RaulBlancoGonzalez/Bionic-Hand-Mano-Bi-nica---2019/IMG/Robot50%.jpg

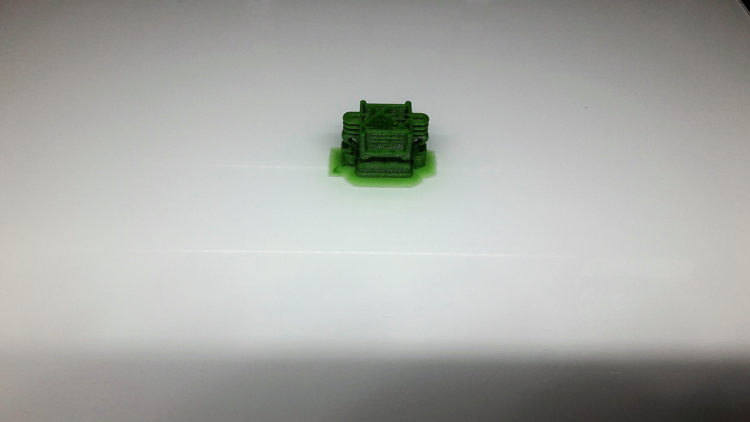
IMG/Robot50%.jpg
