RaulBlancoGonzalez/Bionic-Hand-Mano-Bi-nica---2019/IMG/Robot1%.jpg

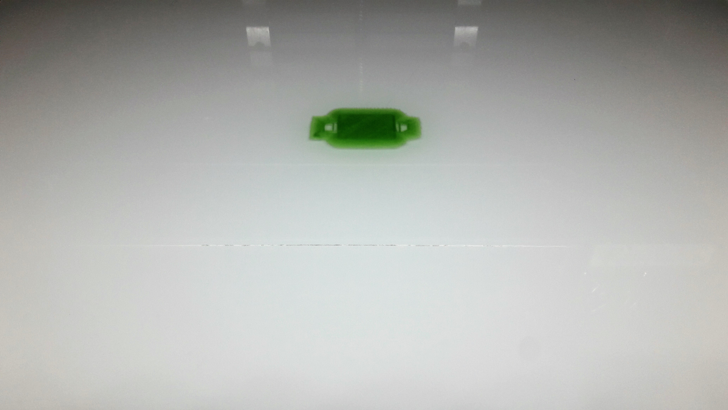
IMG/Robot1%.jpg
