RaulBlancoGonzalez/Bionic-Hand-Mano-Bi-nica---2019/IMG/Arduino_Proto_Shield.jpg

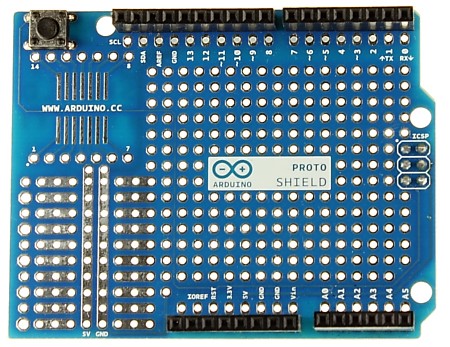
IMG/Arduino_Proto_Shield.jpg
