RaulBlancoGonzalez/Bionic-Hand-Mano-Bi-nica---2019/IMG/Connection.jpg

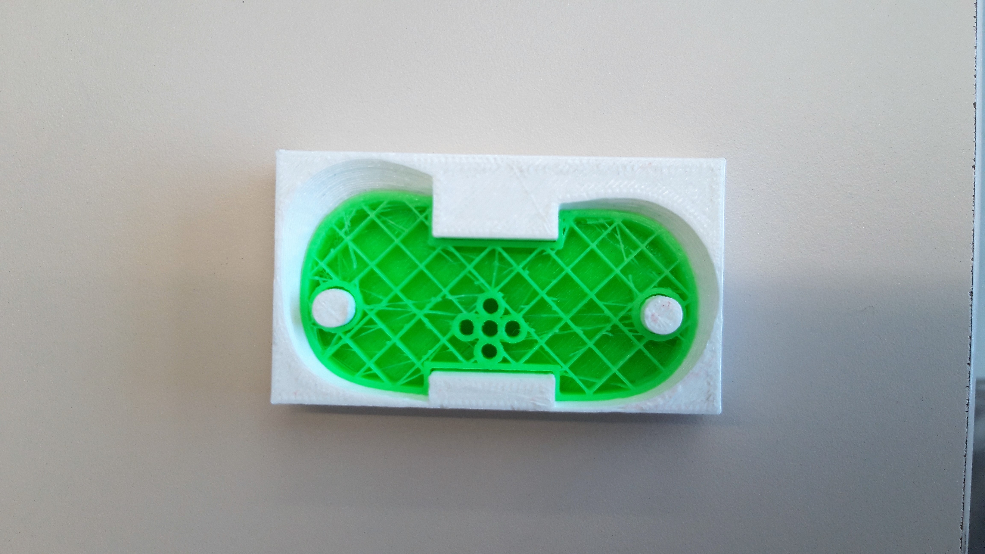
IMG/Connection.jpg
