RaulBlancoGonzalez/Bionic-Hand-Mano-Bi-nica---2019/IMG/Cross_Servo.jpg

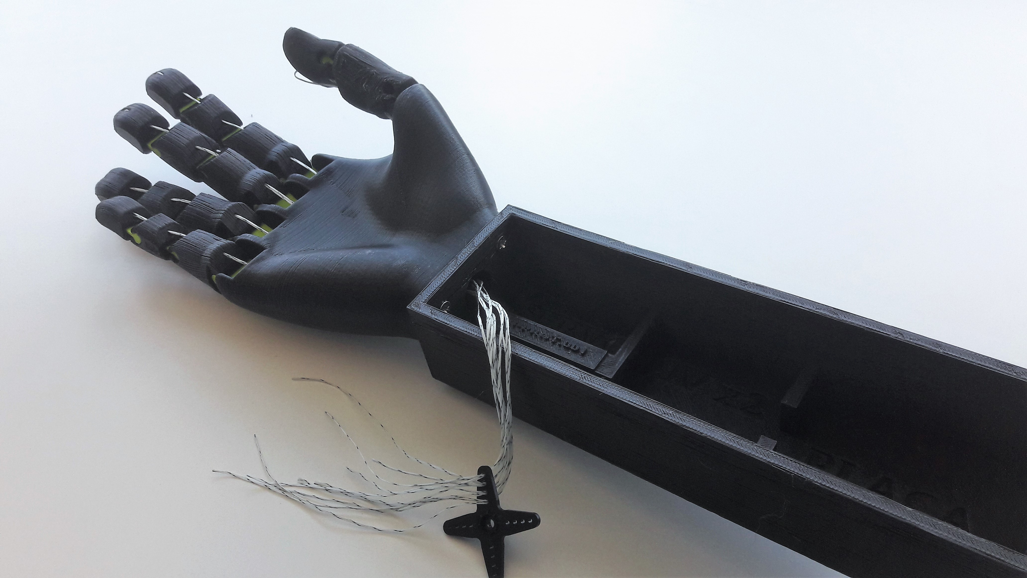
IMG/Cross_Servo.jpg
