RaulBlancoGonzalez/Bionic-Hand-Mano-Bi-nica---2019/IMG/Hand_Close.jpg

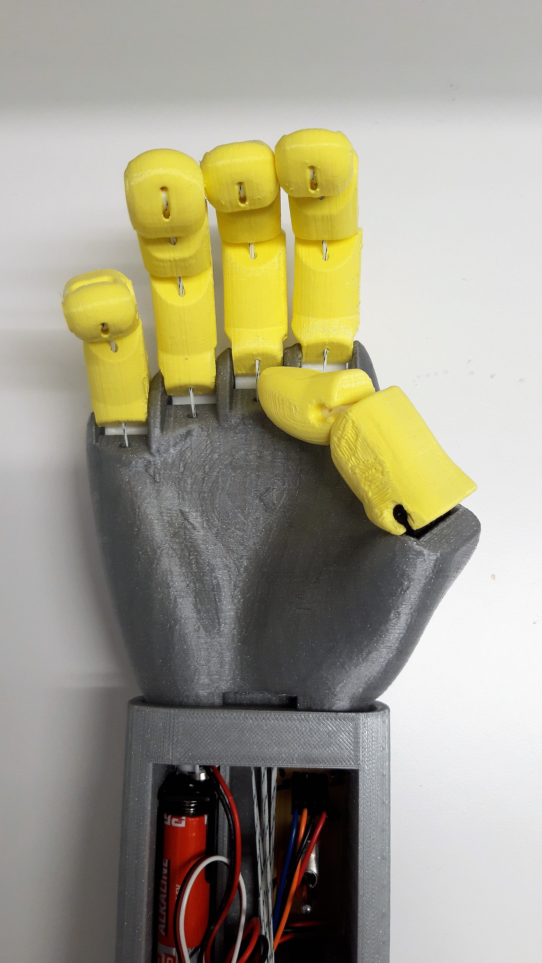
IMG/Hand_Close.jpg
