RaulBlancoGonzalez/Bionic-Hand-Mano-Bi-nica---2019/IMG/Hand_Open.jpg

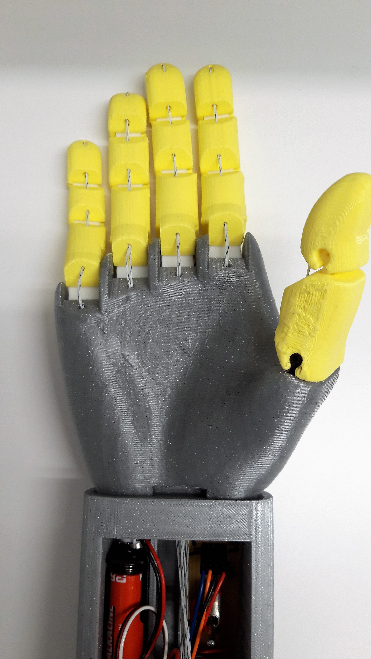
IMG/Hand_Open.jpg
