RaulBlancoGonzalez/Bionic-Hand-Mano-Bi-nica---2019/IMG/PCB.jpg

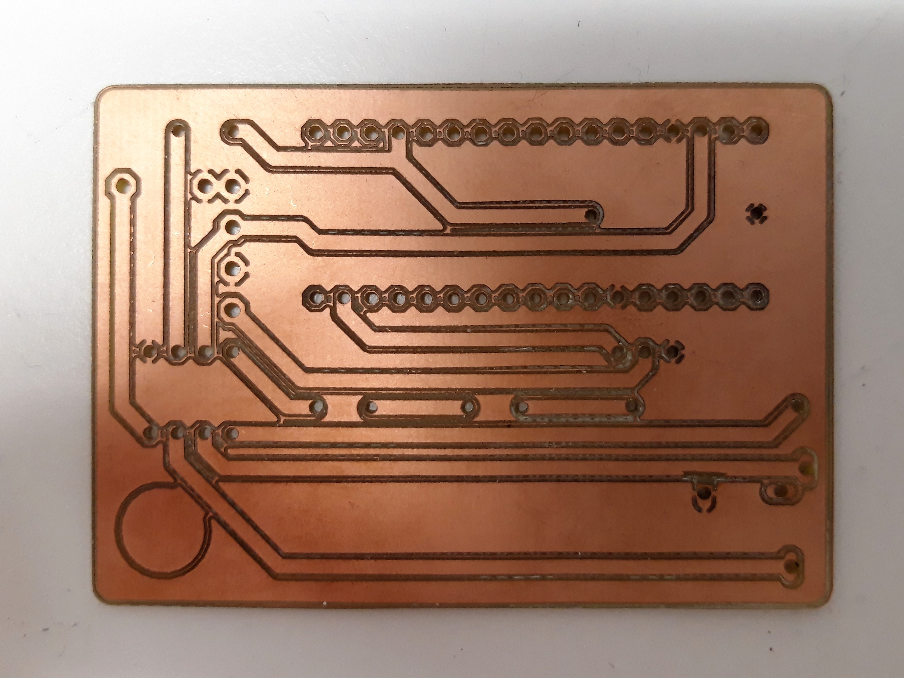
IMG/PCB.jpg
