RaulBlancoGonzalez/Bionic-Hand-Mano-Bi-nica---2019/IMG/PCB_Eagle.jpg

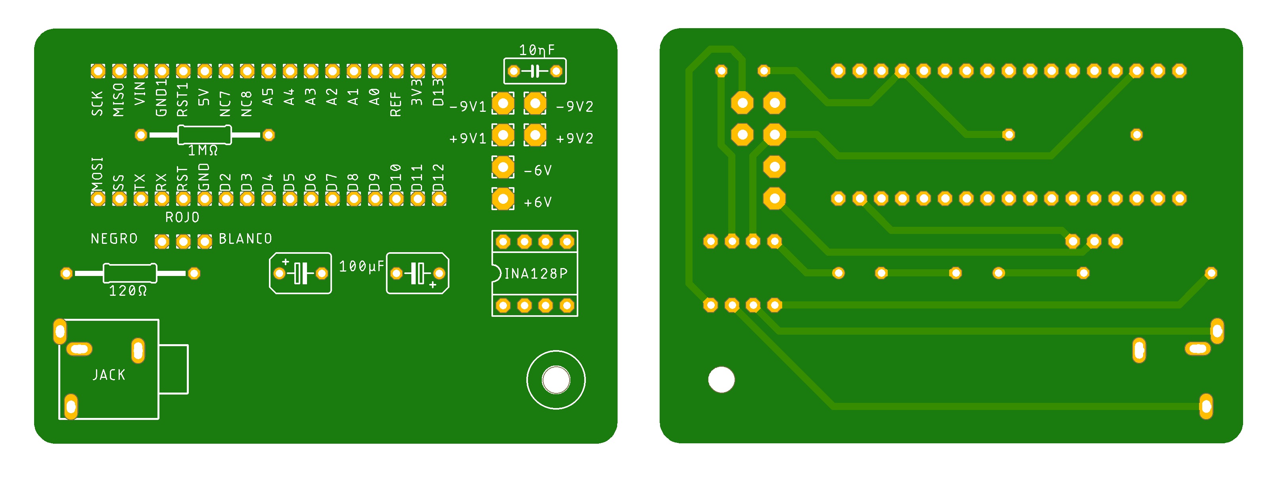
IMG/PCB_Eagle.jpg
