RaulBlancoGonzalez/Bionic-Hand-Mano-Bi-nica---2019/IMG/Robot.jpg

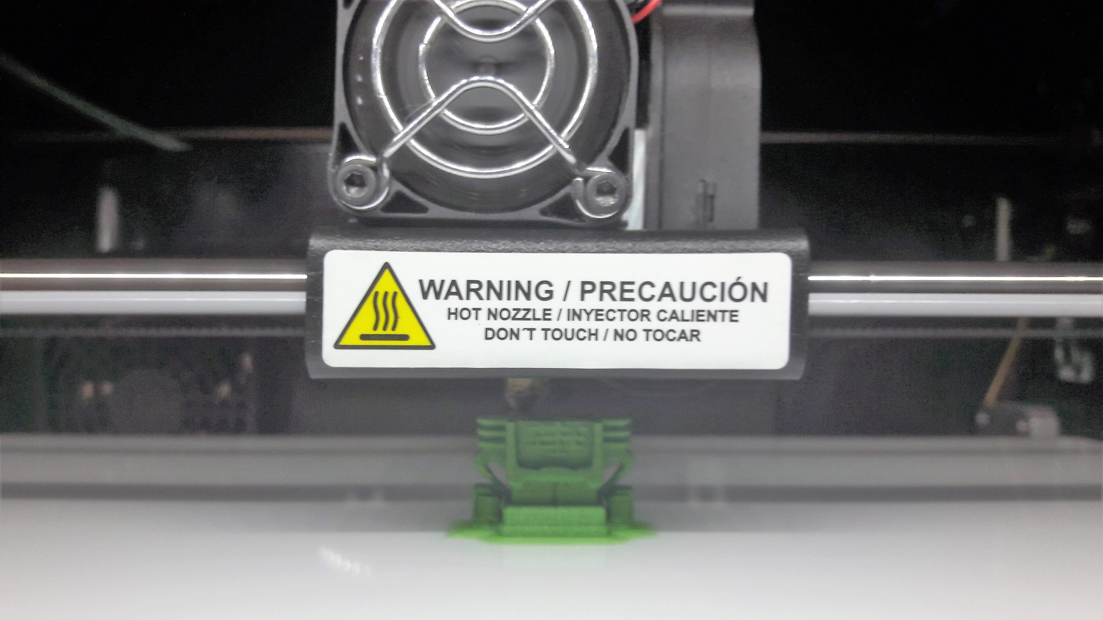
IMG/Robot.jpg
