RaulBlancoGonzalez/Bionic-Hand-Mano-Bi-nica---2019/IMG/Servo_Forearm.jpg

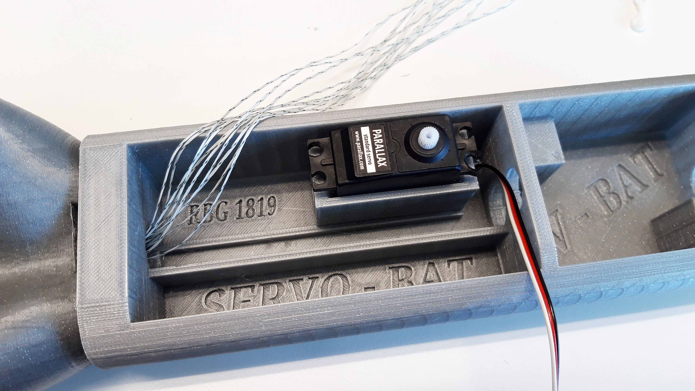
IMG/Servo_Forearm.jpg
