RaulBlancoGonzalez/Bionic-Hand-Mano-Bi-nica---2019/IMG/Stripboard.jpg

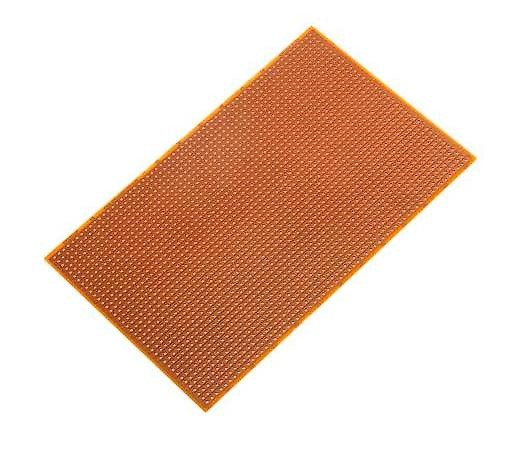
IMG/Stripboard.jpg
