RaulBlancoGonzalez/Bionic-Hand-Mano-Bi-nica---2019/PCB/FINAL/Main_Board/Final_Bottom.png

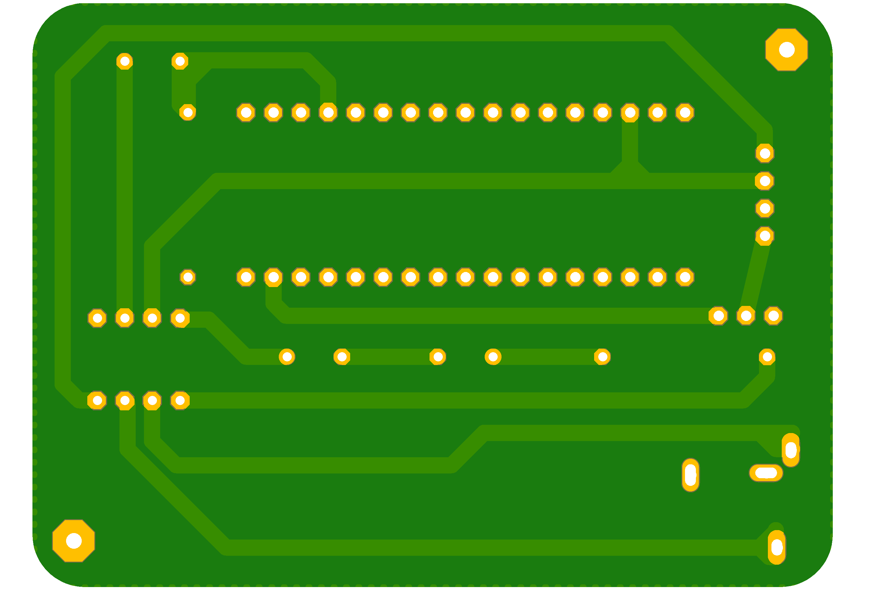
PCB/FINAL/Main_Board/Final_Bottom.png
