RaulBlancoGonzalez/Bionic-Hand-Mano-Bi-nica---2019/PCB/FINAL/Main_Board/Final_Top.png

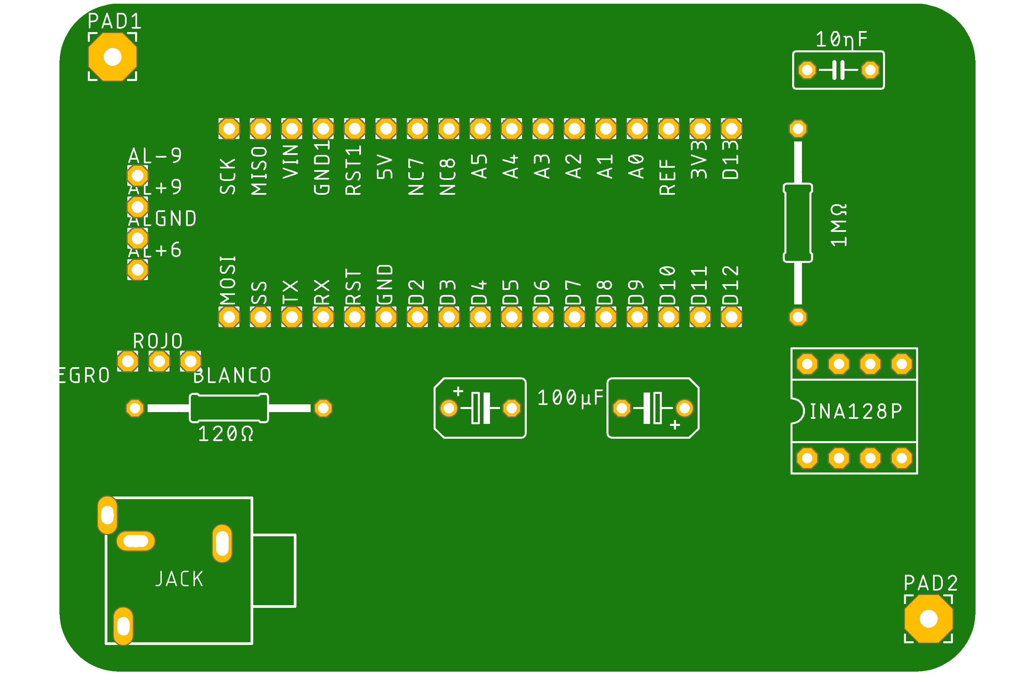
PCB/FINAL/Main_Board/Final_Top.png
