RaulBlancoGonzalez/Bionic-Hand-Mano-Bi-nica---2019/PCB/FINAL/Power_Board/Power_Bottom.png

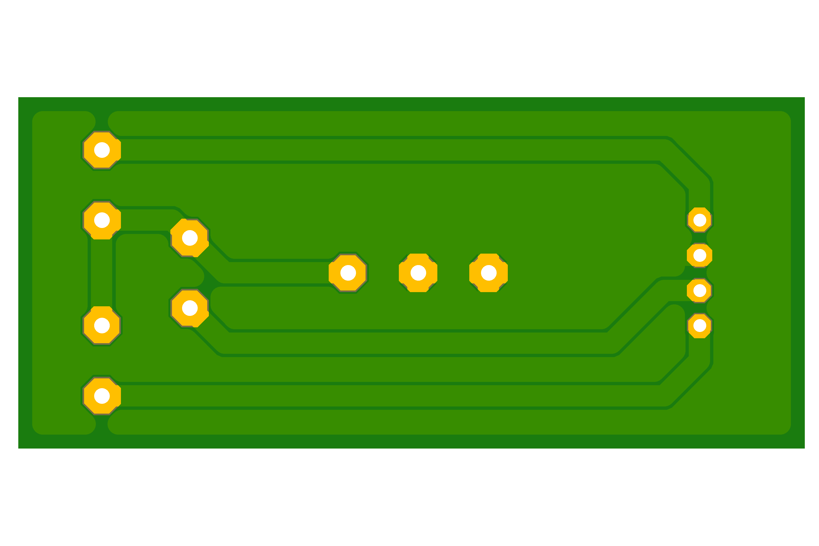
PCB/FINAL/Power_Board/Power_Bottom.png
