RaulBlancoGonzalez/Bionic-Hand-Mano-Bi-nica---2019/PCB/MOD/MOD_Bottom.png

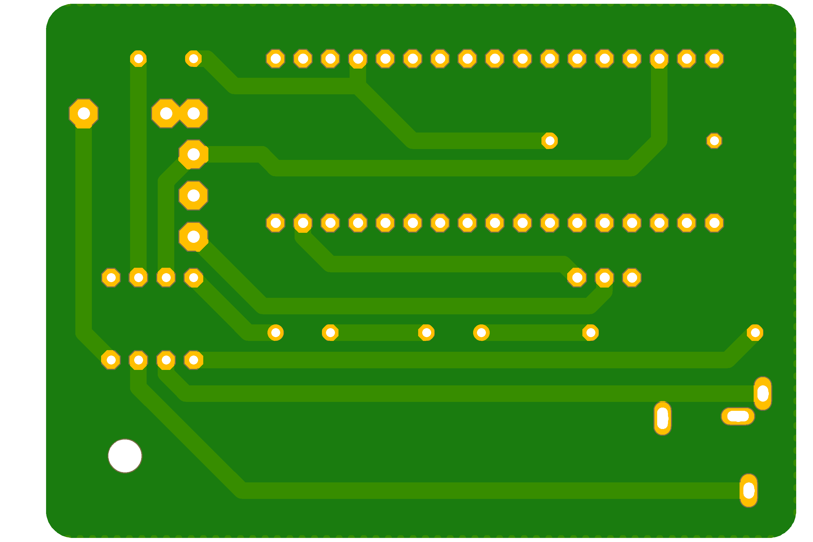
PCB/MOD/MOD_Bottom.png
