RaulBlancoGonzalez/Bionic-Hand-Mano-Bi-nica---2019/PCB/MOD/MOD_Top.png

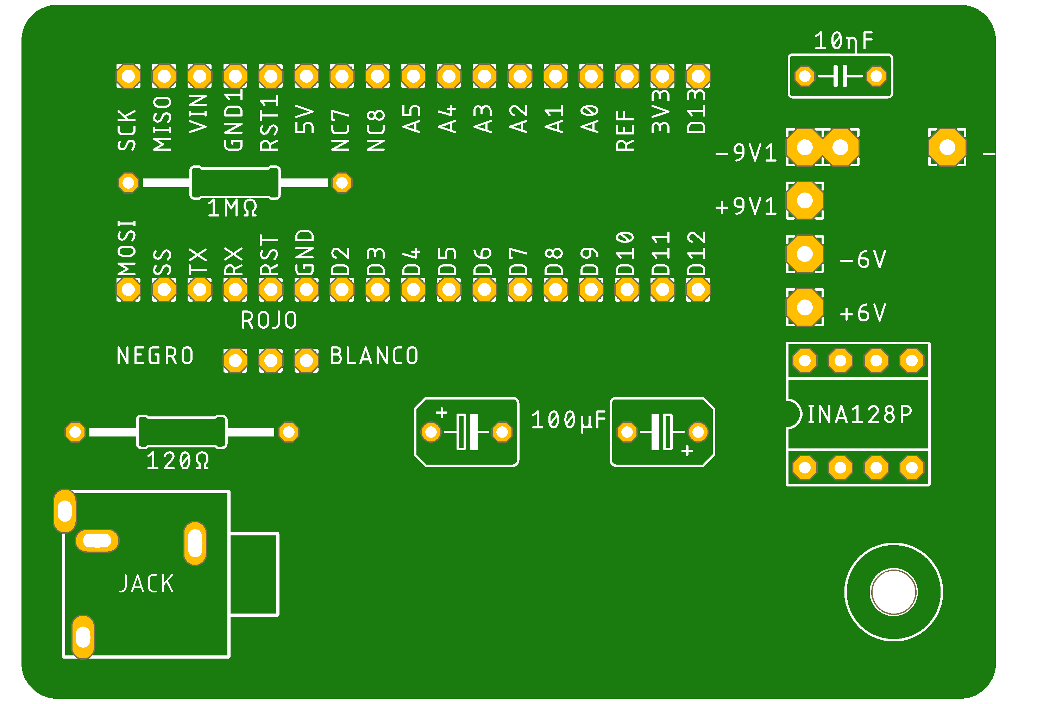
PCB/MOD/MOD_Top.png
