RaulBlancoGonzalez/Bionic-Hand-Mano-Bi-nica---2019/PCB/ORIGINAL/Original_Bottom.png

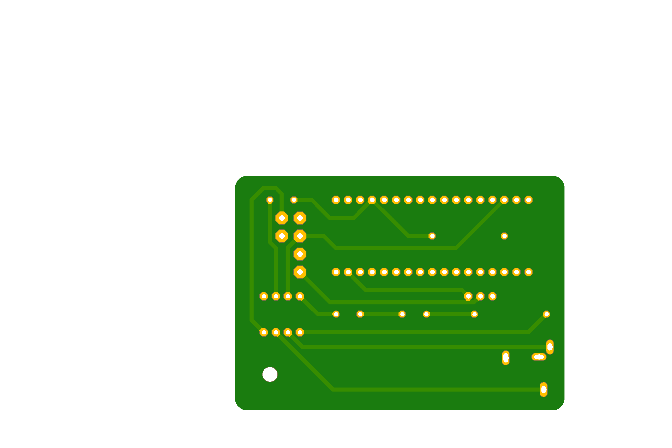
PCB/ORIGINAL/Original_Bottom.png
