RaulBlancoGonzalez/Bionic-Hand-Mano-Bi-nica---2019/PCB/ORIGINAL/Original_Top.png

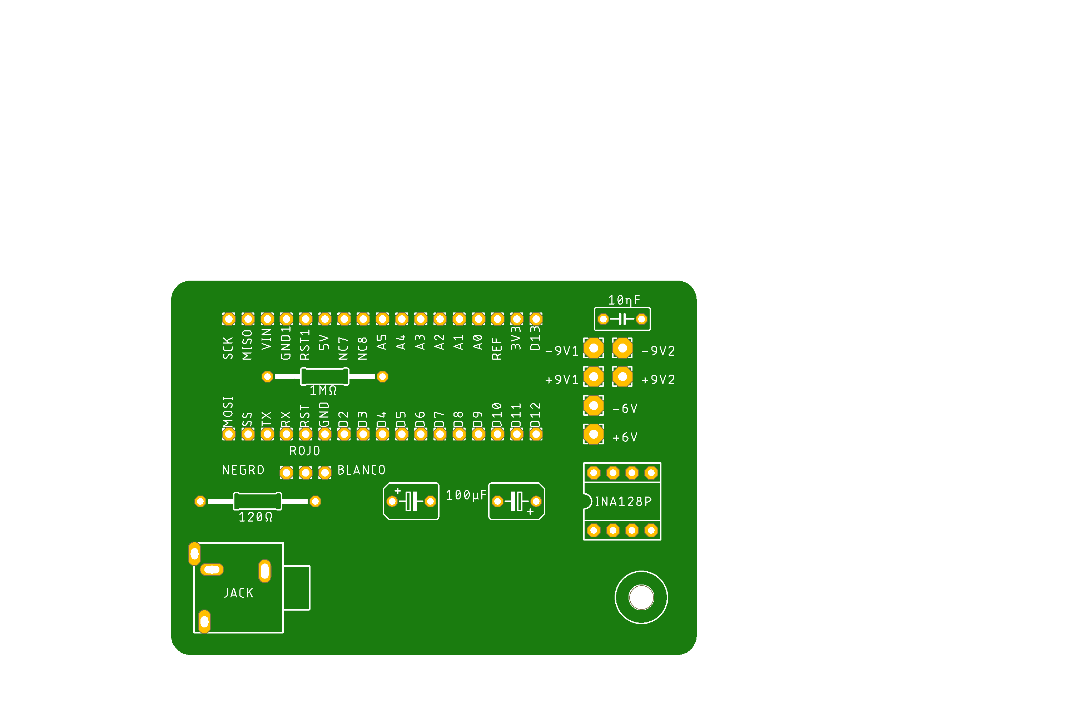
PCB/ORIGINAL/Original_Top.png
