RaulBlancoGonzalez/Bionic-Hand-Mano-Bi-nica---2019/SCH/Arduino_Proto_Shield_Back.jpg

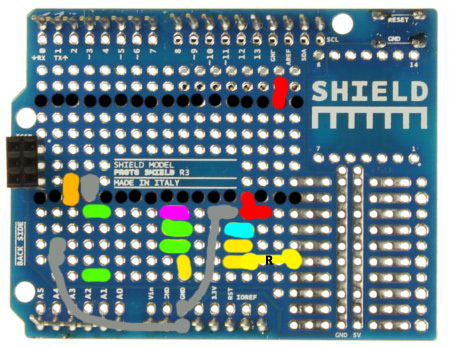
SCH/Arduino_Proto_Shield_Back.jpg
