RaulBlancoGonzalez/Bionic-Hand-Mano-Bi-nica---2019/SCH/EMG.jpg

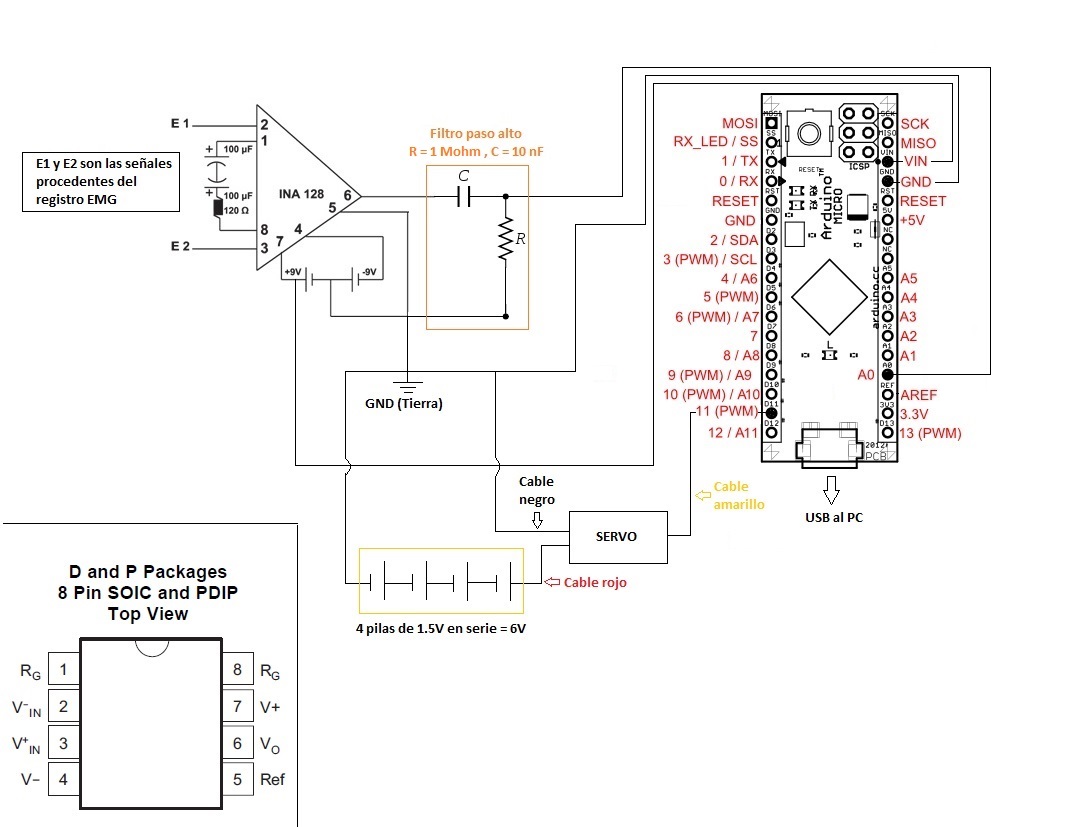
SCH/EMG.jpg
