RaulBlancoGonzalez/Bionic-Hand-Mano-Bi-nica---2019/SCH/Homemade_Scheme_Switch.png

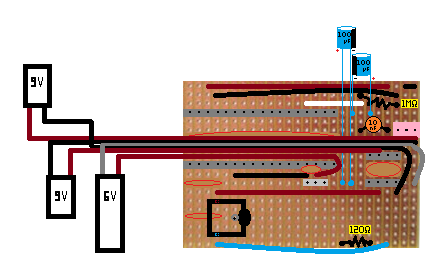
SCH/Homemade_Scheme_Switch.png
