RaulBlancoGonzalez/Bionic-Hand-Mano-Bi-nica---2019/3D/STL/Right_Hand/PLA/Right_Hand_Complete_Set_No_Joints.stl

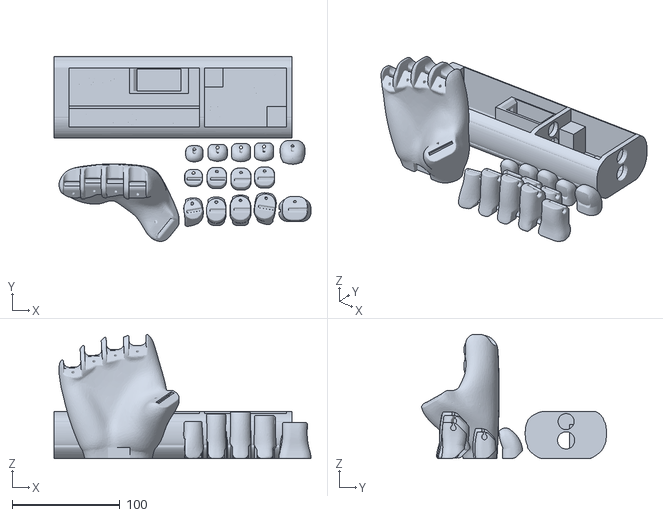
[picture p44: CAD file, 2019-06-21]
3D/STL/Right_Hand/PLA/Right_Hand_Complete_Set_No_Joints.stl
238.8 x 171.8 x 115.6
