RaulBlancoGonzalez/Bionic-Hand-Mano-Bi-nica---2019/3D/STL/Left_Hand/FLEX/Small_Joint.stl

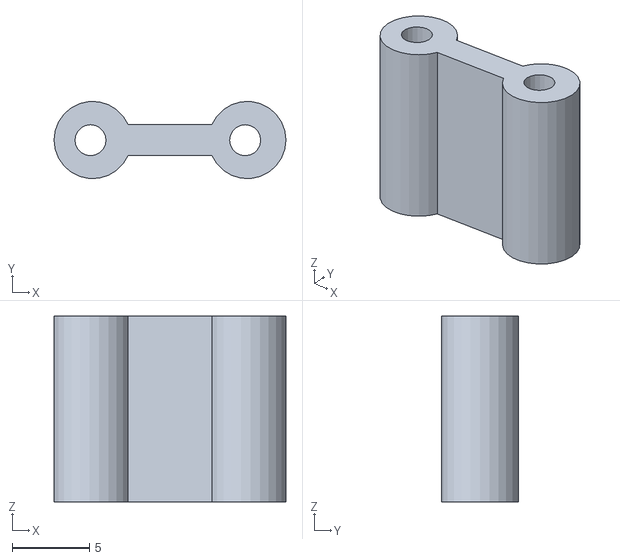
[picture p45: CAD file, 2019-06-21]
3D/STL/Left_Hand/FLEX/Small_Joint.stl
15.0 x 4.98 x 12.0
