RaulBlancoGonzalez/Bionic-Hand-Mano-Bi-nica---2019/3D/STL/Left_Hand/PLA/Left_Fingers.stl

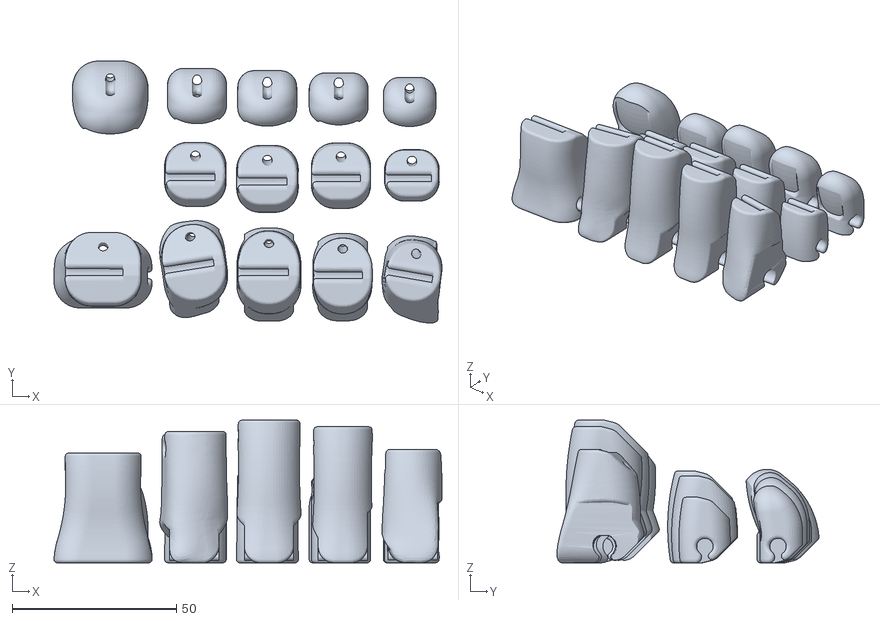
[picture p46: CAD file, 2019-06-21]
3D/STL/Left_Hand/PLA/Left_Fingers.stl
118.3 x 79.9 x 43.5
