RaulBlancoGonzalez/Bionic-Hand-Mano-Bi-nica---2019/3D/STL/Right_Hand/FLEX/Joint_Set.stl

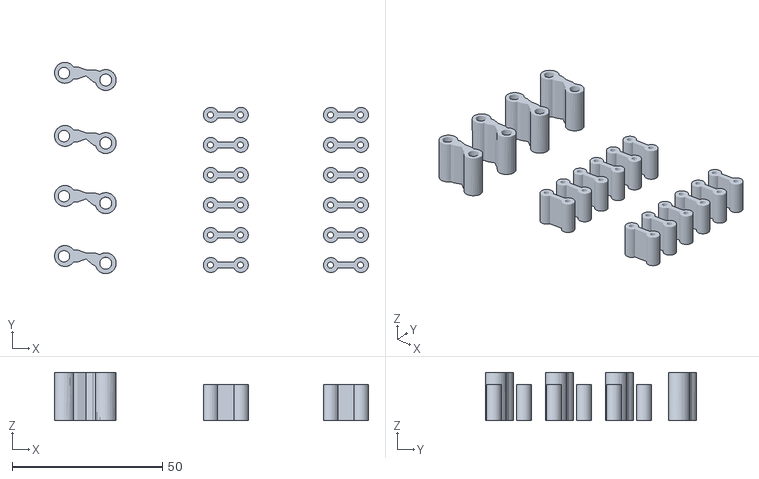
[picture p47: CAD file, 2019-06-21]
3D/STL/Right_Hand/FLEX/Joint_Set.stl
104.5 x 70.4 x 16.0
