RaulBlancoGonzalez/Bionic-Hand-Mano-Bi-nica---2019/3D/STL/Right_Hand/PLA/Right_Hand.stl

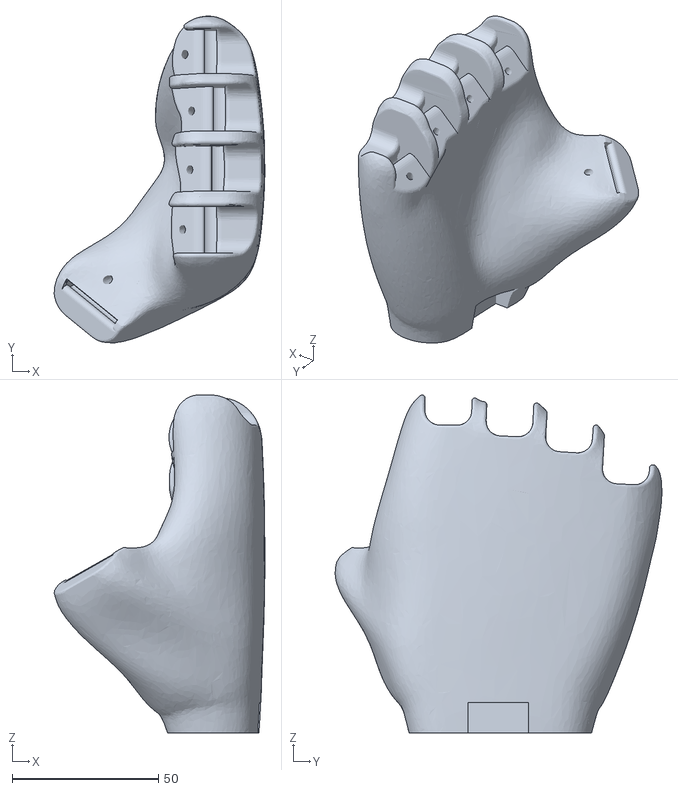
[picture p48: CAD file, 2019-06-21]
3D/STL/Right_Hand/PLA/Right_Hand.stl
72.0 x 111.7 x 115.6
