RaulBlancoGonzalez/Bionic-Hand-Mano-Bi-nica---2019/3D/STL/Left_Hand/PLA/Left_Forearm.stl

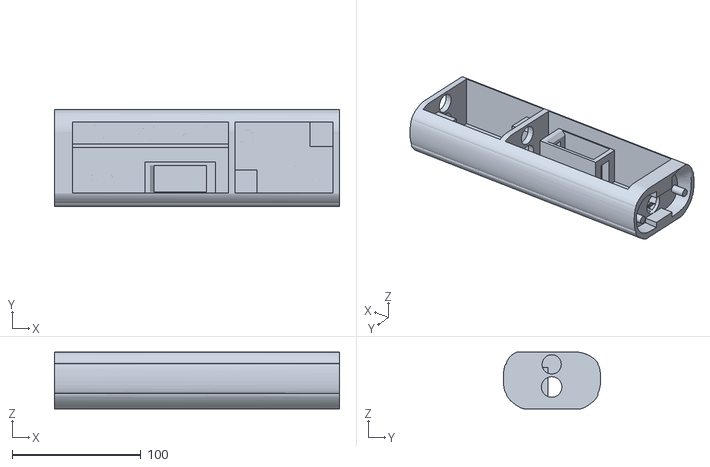
[picture p49: CAD file, 2019-06-21]
3D/STL/Left_Hand/PLA/Left_Forearm.stl
221.0 x 75.5 x 44.0
