RaulBlancoGonzalez/Bionic-Hand-Mano-Bi-nica---2019/3D/STL/Right_Hand/FLEX/Big_Joint.stl

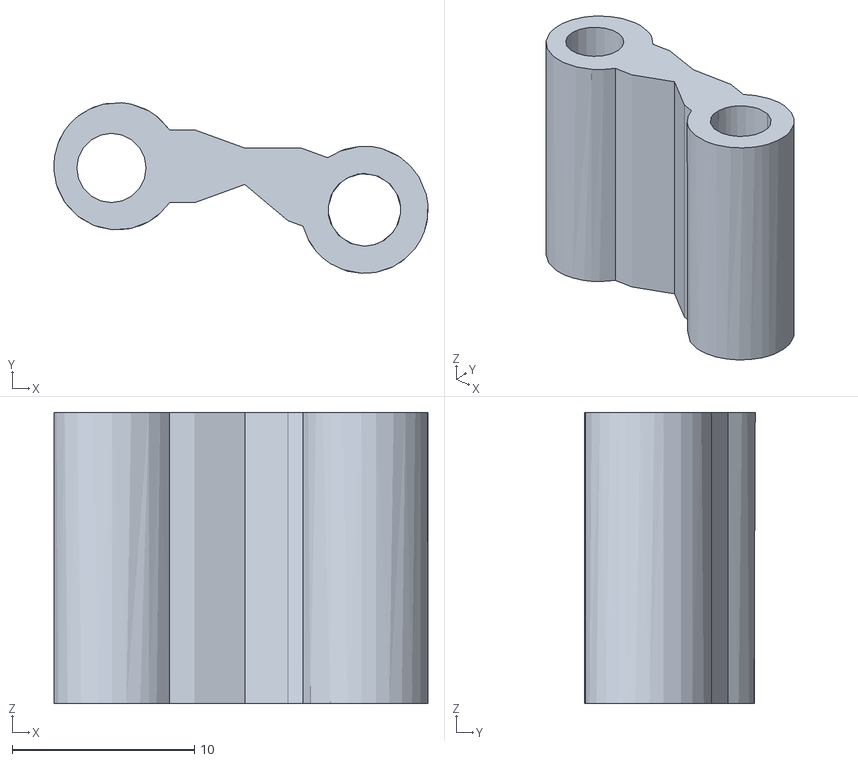
[picture p50: CAD file, 2019-06-21]
3D/STL/Right_Hand/FLEX/Big_Joint.stl
20.5 x 9.37 x 16.0
