RaulBlancoGonzalez/Bionic-Hand-Mano-Bi-nica---2019/3D/STL/Right_Hand/PLA/Right_Forearm.stl

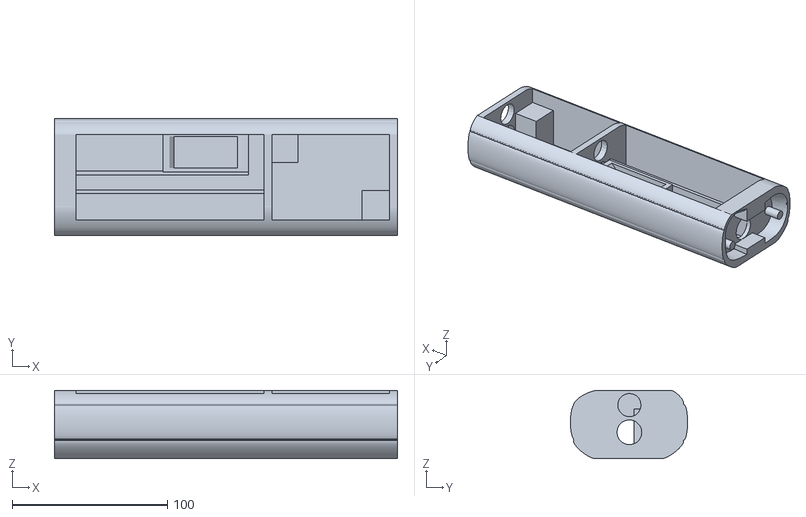
[picture p51: CAD file, 2019-06-21]
3D/STL/Right_Hand/PLA/Right_Forearm.stl
221.0 x 75.5 x 44.0
