RaulBlancoGonzalez/Bionic-Hand-Mano-Bi-nica---2019/(list of files, cad)

Other CAD files:
3D/STL/Left_Hand/PLA/Left_Hand.stl
3D/STL/Right_Hand/PLA/Right_Fingers.stl
