RaulBlancoGonzalez/Bionic-Hand-Mano-Bi-nica---2019/PCB/MOD/MOD.pdf

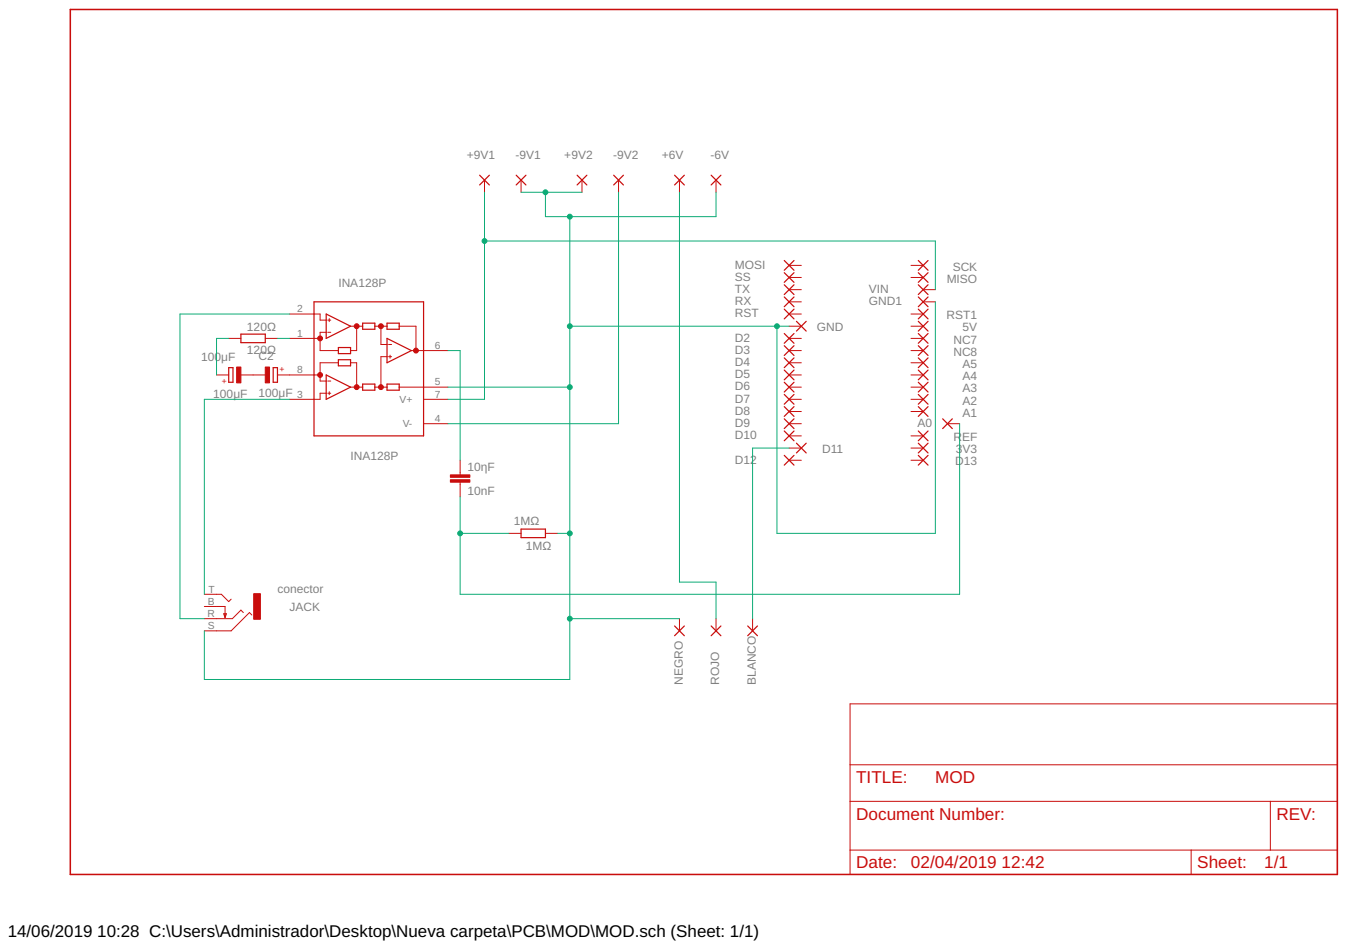
[picture p52: page 1]

Document Number: | REV:

Date: 02/04/2019 12:42 | Sheet: 1/1

14/06/2019 10:28 C:\Users\Administrador\Desktop\Nueva carpeta\PCB\MOD\MOD.sch (Sheet: 1/1)
