RaulBlancoGonzalez/Bionic-Hand-Mano-Bi-nica---2019/PCB/FINAL/Main_Board/Final.pdf

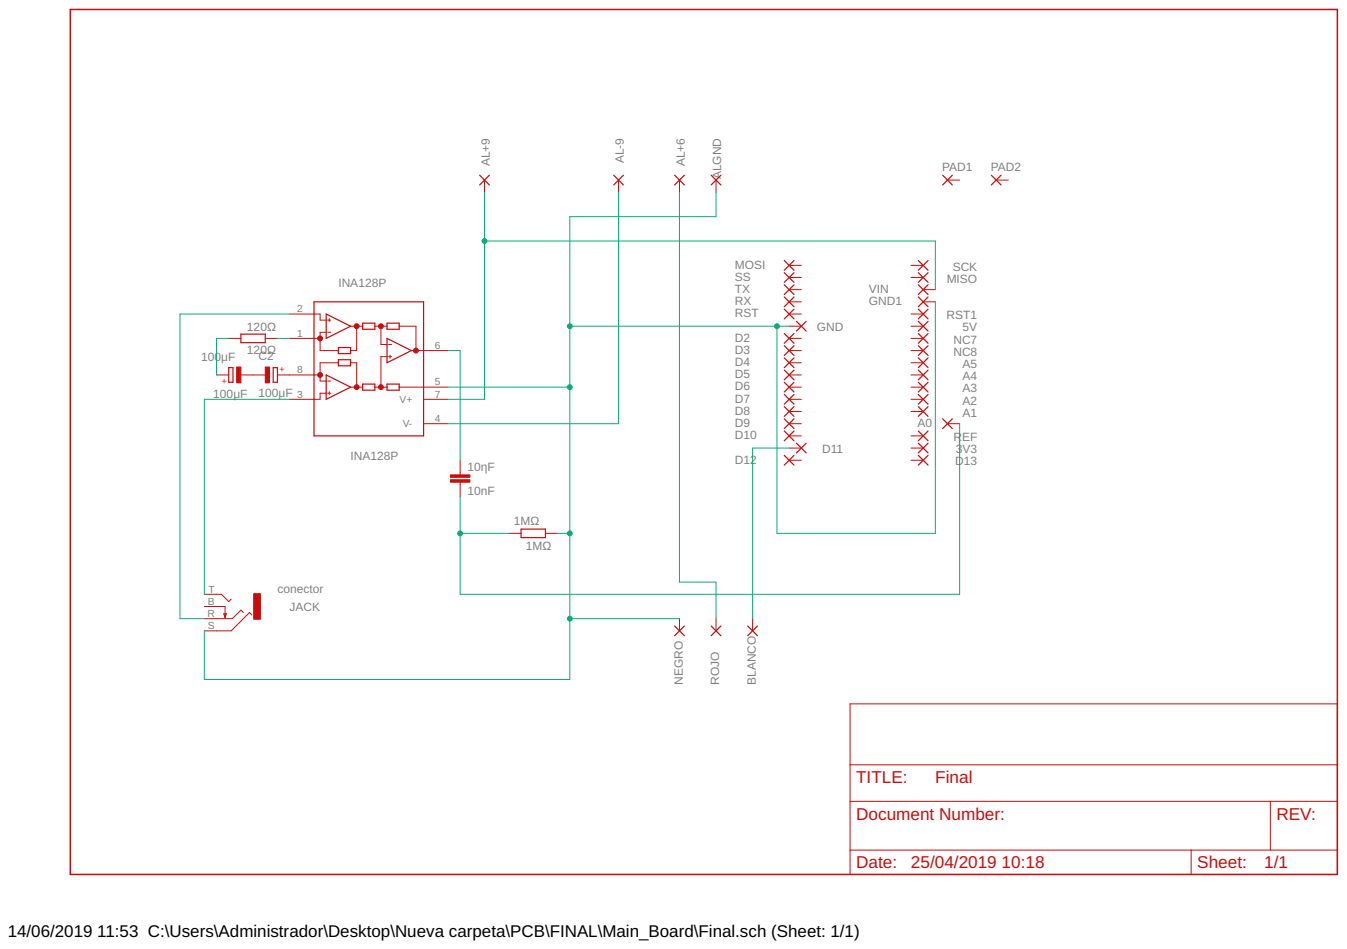
[picture p53: page 1]

Document Number: | REV:

Date: 25/04/2019 10:18 | Sheet: 1/1

14/06/2019 11:53 C:\Users\Administrador\Desktop\Nueva carpeta\PCB\FINAL\Main_Board\Final.sch (Sheet: 1/1)
