RaulBlancoGonzalez/Bionic-Hand-Mano-Bi-nica---2019/PCB/ORIGINAL/Original.pdf

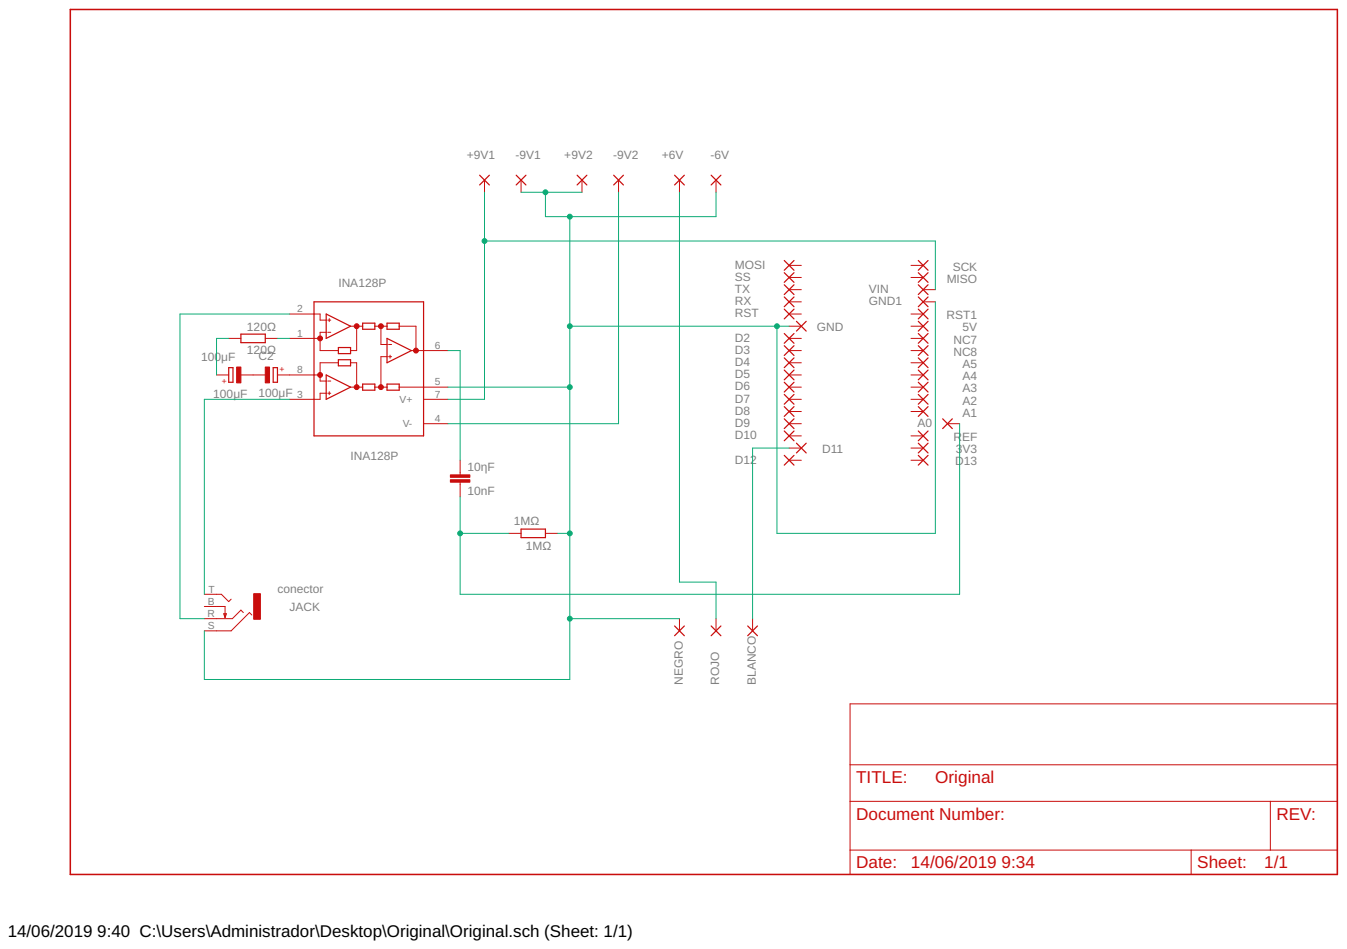
[picture p54: page 1]

Document Number: | REV:

Date: 14/06/2019 9:34 | Sheet: 1/1

14/06/2019 9:40 C:\Users\Administrador\Desktop\Original\Original.sch (Sheet: 1/1)
