RaulBlancoGonzalez/Bionic-Hand-Mano-Bi-nica---2019/PCB/ORIGINAL/Original.brd

## EAGLE design PCB/ORIGINAL/Original.brd (2019-06-21)

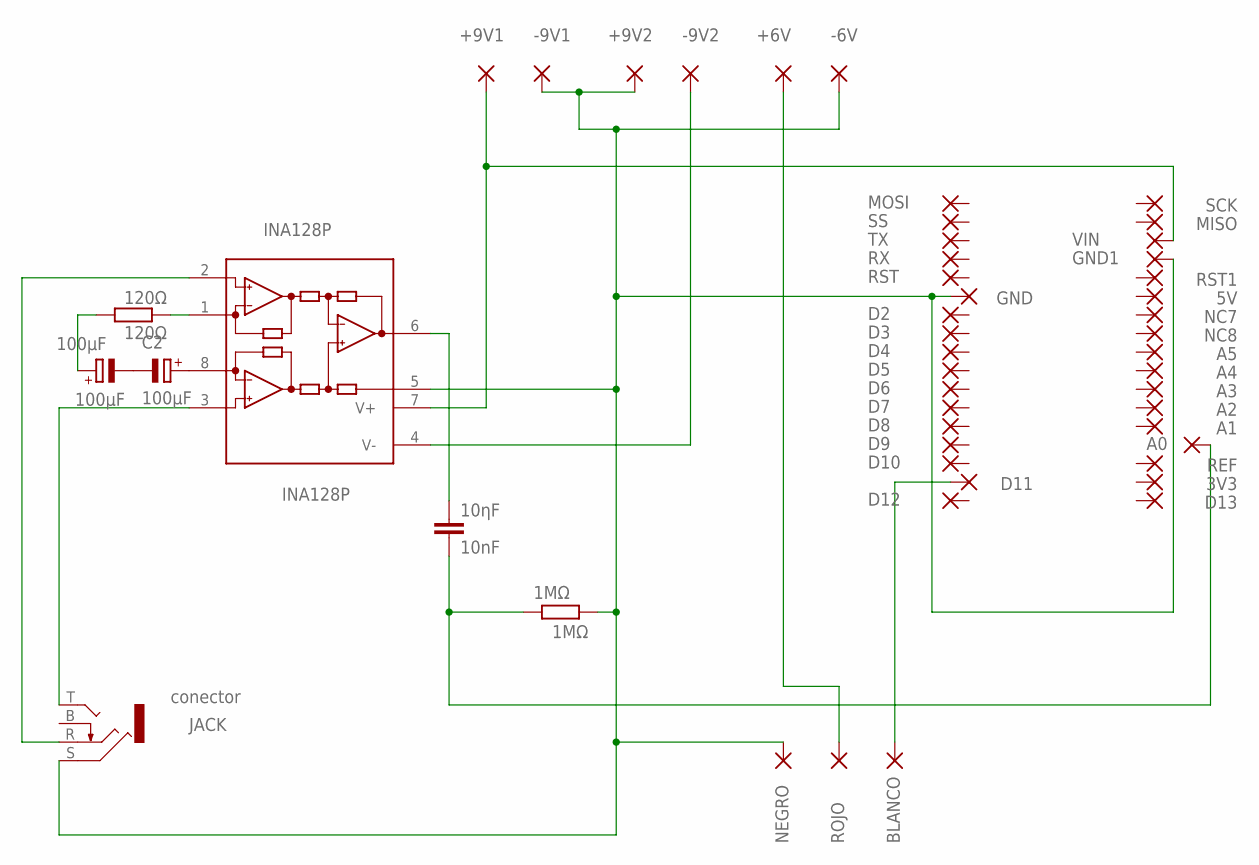
[picture p55: schematic Original.sch]

Parts:
1MΩ: 1MΩ; 0207/15
3V3, 5V: 1,6/0,9
10ηF: 10nF; C050-030X075
100μF: 100μF; B45181B
120Ω: 120Ω; 0207/15
+6V, +9V1, +9V2: 2,54/1,1
-6V, -9V1, -9V2: 2,54/1,1
A0, A1, A2, A3, A4, A5: 1,6/0,9
BLANCO: 1,6/0,9
C2: 100μF; B45181B
D2, D3, D4, D5, D6, D7, D8, D9, D10, D11, D12, D13: 1,6/0,9
GND, GND1: 1,6/0,9
INA128P: INA128P; DIL08
JACK: conector; KLBR4
MISO: 1,6/0,9
MOSI: 1,6/0,9
NC7, NC8: 1,6/0,9
NEGRO: 1,6/0,9
REF: 1,6/0,9
ROJO: 1,6/0,9
RST, RST1: 1,6/0,9
RX: 1,6/0,9
SCK: 1,6/0,9
SS: 1,6/0,9
TX: 1,6/0,9
VIN: 1,6/0,9

Connections:
+6VCC: +6V.1, ROJO.1
+9VCC: +9V1.1, INA128P.7 (V+), VIN.1
-9VCC: -9V2.1, INA128P.4 (V-)
A0: 1MΩ.2, 10ηF.2, A0.1
CONTROL_SERVO: BLANCO.1, D11.1
E1: INA128P.2 (-IN), JACK.R
E2: INA128P.3 (+IN), JACK.T
GND: 1MΩ.1, +9V2.1, -6V.1, -9V1.1, GND.1, GND1.1, INA128P.5 (REF), JACK.S, NEGRO.1
unnamed: C2.+, INA128P.8 (RG)
unnamed: 100μF.-, C2.-
unnamed: 120Ω.2, INA128P.1 (RG)
unnamed: 100μF.+, 120Ω.1
unnamed: 10ηF.1, INA128P.6 (OUT)

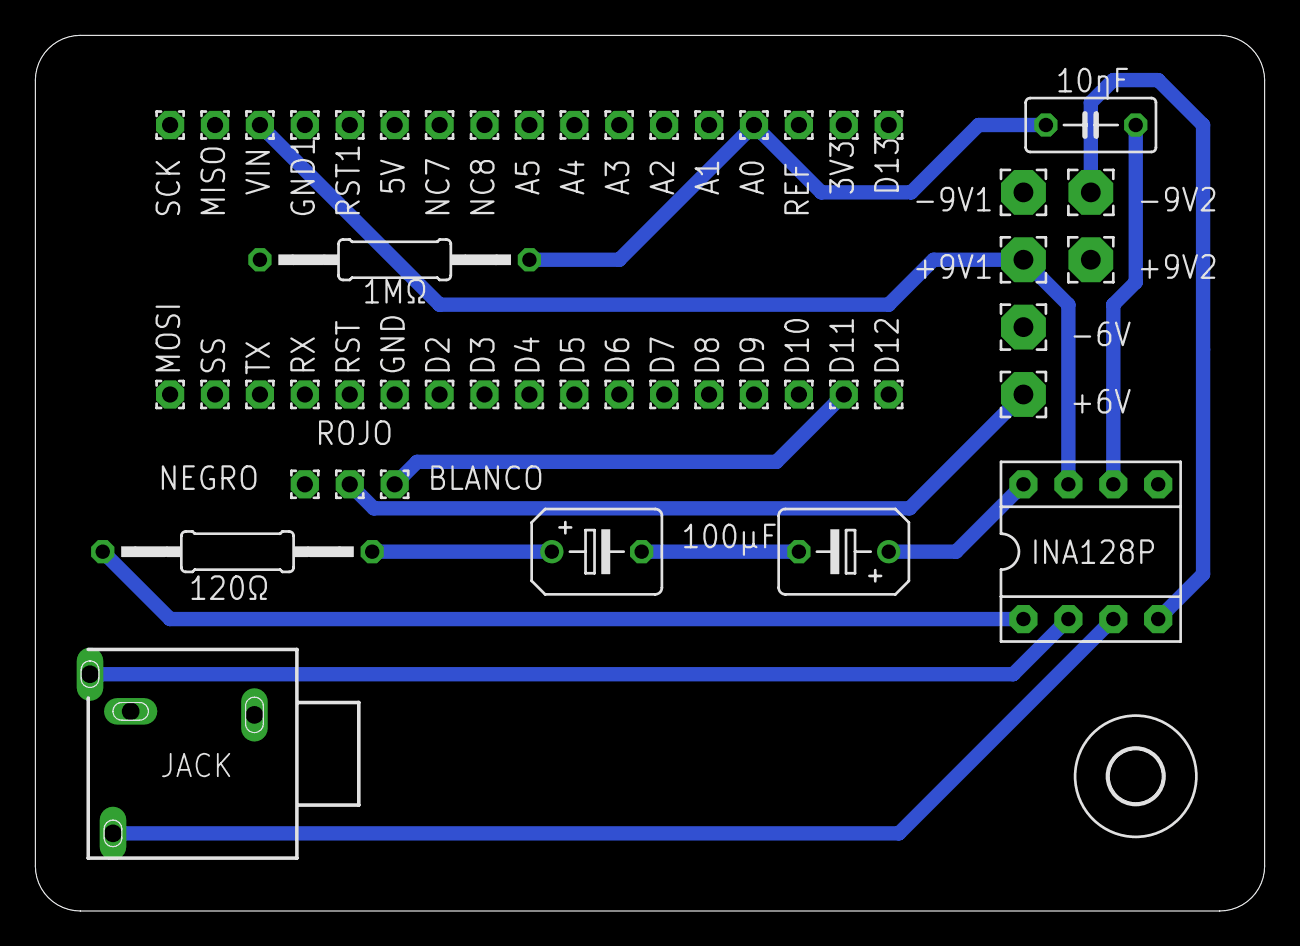
[picture p56: board Original.brd from above]

Board: 2 copper layers, 69.5 x 49.5 mm, 51 parts (0 on the bottom side), 13 nets.

Other parts of the board:
U$2: 3,0
