RaulBlancoGonzalez/Bionic-Hand-Mano-Bi-nica---2019/PCB/FINAL/Power_Board/Power.brd

## EAGLE design PCB/FINAL/Power_Board/Power.brd (2019-06-21)

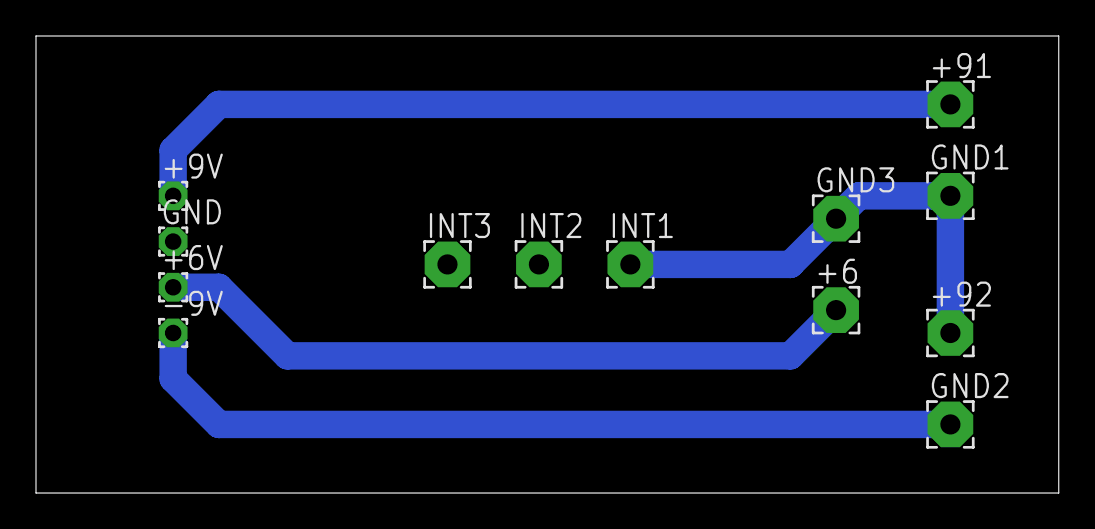
[picture p57: board Power.brd from above]

Board: 2 copper layers, 56.8 x 25.4 mm, 13 parts (0 on the bottom side), 5 nets.

Parts:
+6, +91, +92: 2,54/1,1
+6V, +9V: 1,6/0,9
-9V: 1,6/0,9
GND: 1,6/0,9
GND1, GND2, GND3: 2,54/1,1
INT1, INT2, INT3: 2,54/1,1

Connections:
6POS: +6.1, +6V.1
9NEG: -9V.1, GND2.1
9POS: +9V.1, +91.1
GND: GND.1, INT2.1, INT3.1
NEG123: +92.1, GND1.1, GND3.1, INT1.1
